qb-creates/pov-led-clock/images/case-inside.JPEG

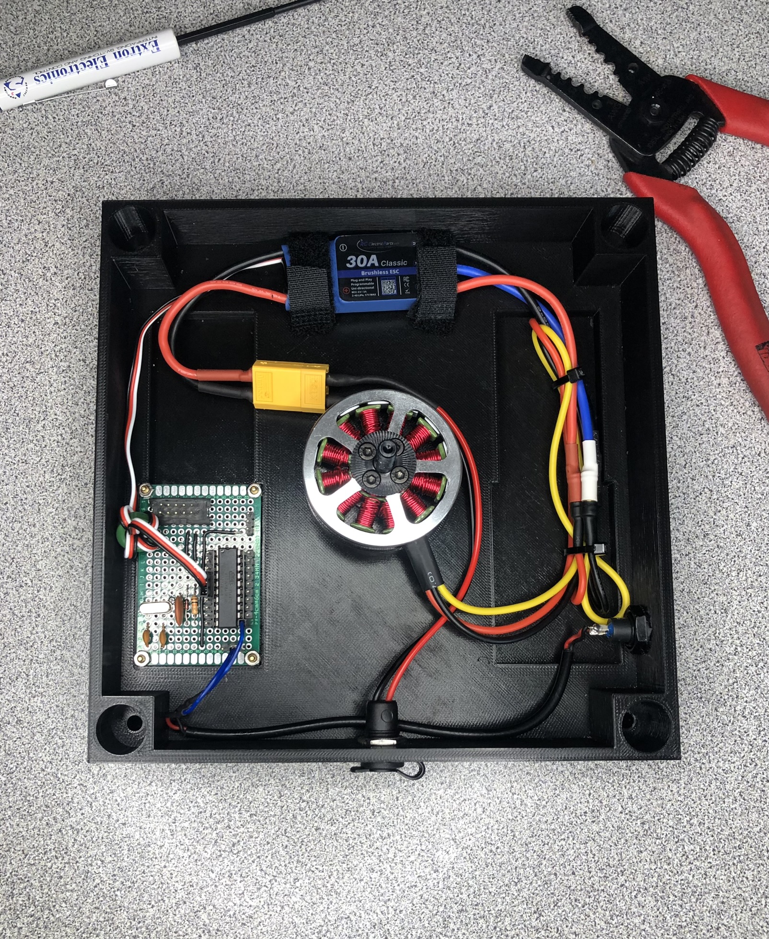
images/case-inside.JPEG
