qb-creates/pov-led-clock/images/pov-led-clock.JPEG

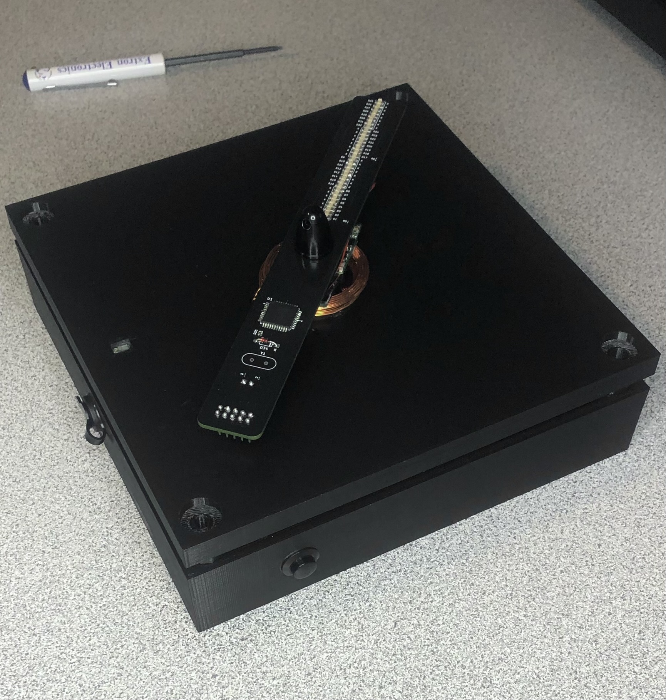
images/pov-led-clock.JPEG
