qb-creates/pov-led-clock/case/pov-clock-case.stl

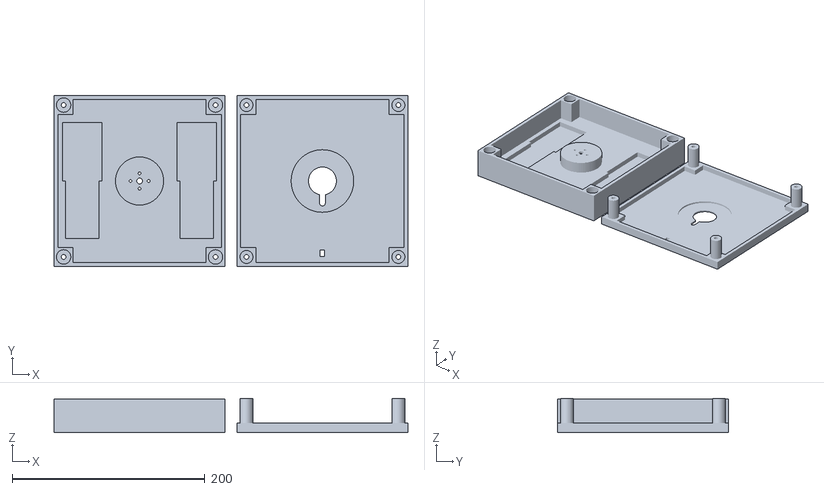
[picture p12: CAD file, 2023-10-21]
case/pov-clock-case.stl
367.8 x 177.8 x 35.4
