qb-creates/pov-led-clock/(list of files, cad)

Other CAD files:
case/pov-clock-case.f3d
