qb-creates/pov-led-clock/eda/pov-clock-kicad/LedClock.kicad_pcb

## KiCad design eda/pov-clock-kicad/LedClock.kicad_pcb (2023-05-27)

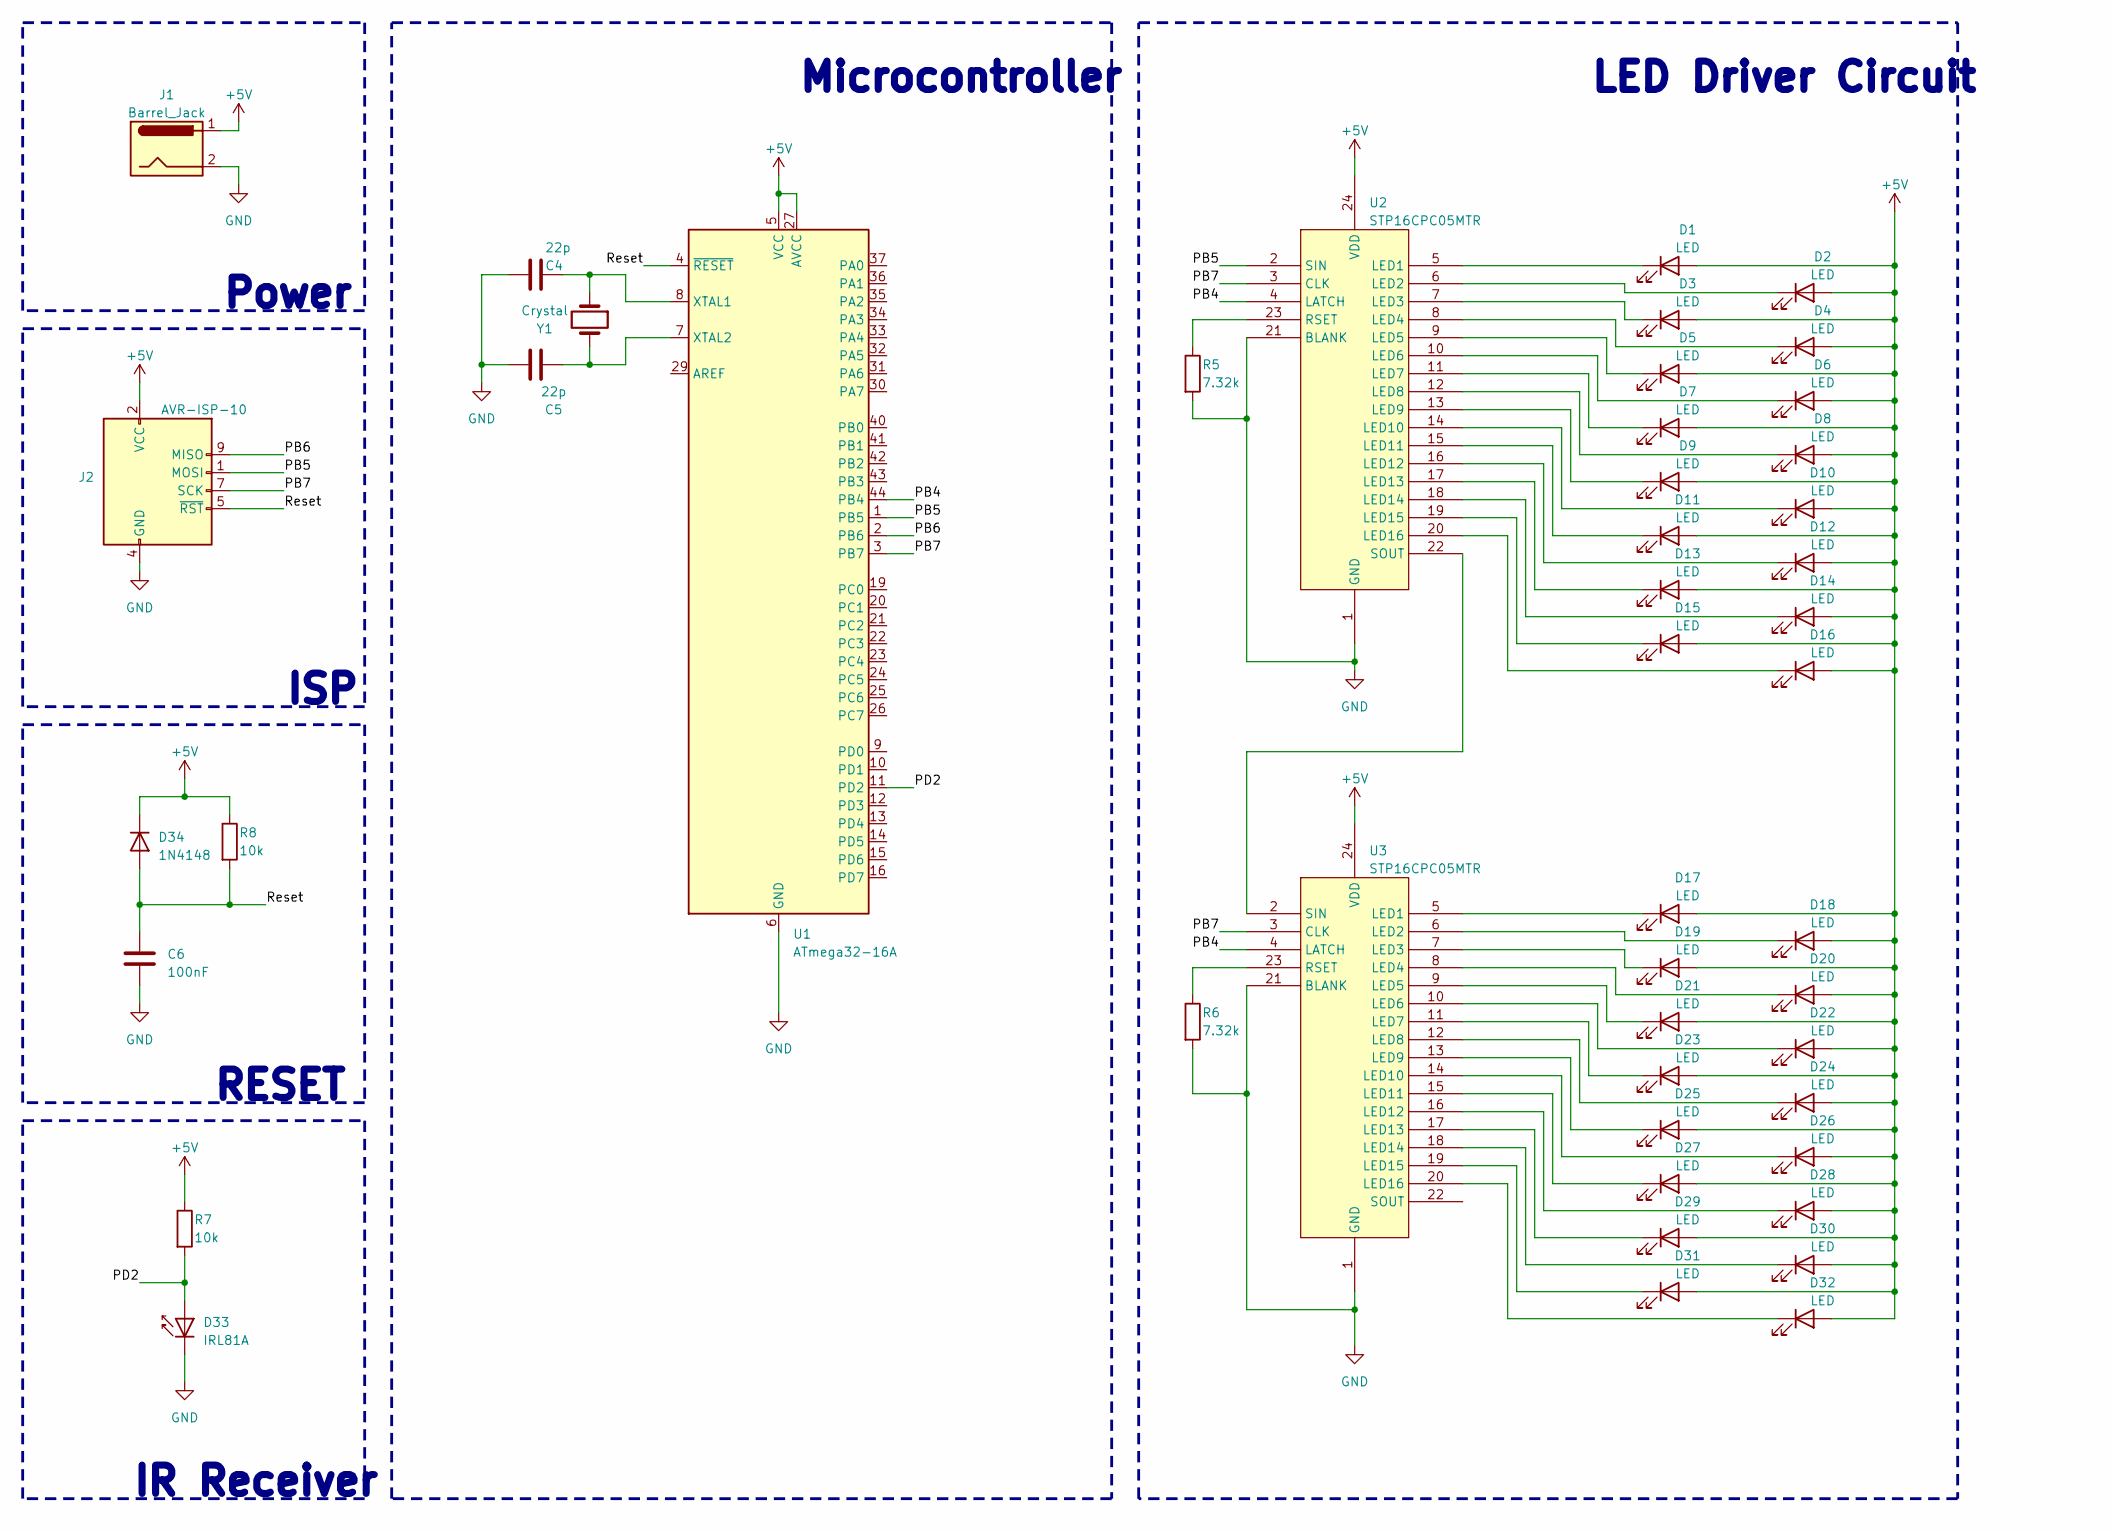
[picture p13: schematic LedClock.kicad_sch]

Parts:
C4, C5: 22p; C_0603_1608Metric
C6: 100nF; C_0603_1608Metric
D1, D2, D3, D4, D5, D6, D7, D8, D9, D10, D11, D12, D13, D14, D15, D16, D17, D18, D19, D20, D21, D22, D23, D24, D25, D26, D27, D28, D29, D30, D31, D32: LED; LED_1206_3216Metric
D33: IRL81A; LED_SideEmitter_Rectangular_W4.5mm_H1.6mm
D34: 1N4148; D_DO-35_SOD27_P7.62mm_Horizontal
J1: Barrel_Jack; JST_PH_S2B-PH-SM4-TB_1x02-1MP_P2.00mm_Horizontal
J2: AVR-ISP-10; ISP-10
R5, R6: 7.32k; R_0603_1608Metric
R7, R8: 10k; R_0603_1608Metric
U1: ATmega32-16A; TQFP-44_10x10mm_P0.8mm
U2, U3: STP16CPC05MTR; SOIC-24W_7.5x15.4mm_P1.27mm
Y1: Crystal; Crystal_HC49-4H_Vertical

Connections:
+5V: D1.2 (A), D2.2 (A), D3.2 (A), D4.2 (A), D5.2 (A), D6.2 (A), D7.2 (A), D8.2 (A), D9.2 (A), D10.2 (A), D11.2 (A), D12.2 (A), D13.2 (A), D14.2 (A), D15.2 (A), D16.2 (A), D17.2 (A), D18.2 (A), D19.2 (A), D20.2 (A), D21.2 (A), D22.2 (A), D23.2 (A), D24.2 (A), D25.2 (A), D26.2 (A), D27.2 (A), D28.2 (A), D29.2 (A), D30.2 (A), D31.2 (A), D32.2 (A), D34.1 (K), J1.1, J2.2 (VCC), R7.1, R8.1, U1.5 (VCC), U1.17 (VCC), U1.27 (AVCC), U1.38 (VCC), U2.24 (VDD), U3.24 (VDD)
/PB4: U1.44 (PB4), U2.4 (LATCH), U3.4 (LATCH)
/PB5: J2.1 (MOSI), U1.1 (PB5), U2.2 (SIN)
/PB6: J2.9 (MISO), U1.2 (PB6)
/PB7: J2.7 (SCK), U1.3 (PB7), U2.3 (CLK), U3.3 (CLK)
/PD2: D33.2 (A), R7.2, U1.11 (PD2)
/Reset: C6.1, D34.2 (A), J2.5 (~RST), R8.2, U1.4 (~RESET)
GND: C4.2, C5.2, C6.2, D33.1 (K), J1.2, J2.4 (GND), J2.6 (GND), J2.8 (GND), J2.10 (GND), R5.2, R6.2, U1.6 (GND), U1.18 (GND), U1.28 (GND), U1.39 (GND), U2.1 (GND), U2.21 (BLANK), U3.1 (GND), U3.21 (BLANK)
unnamed: D1.1 (K), U2.5 (LED1)
unnamed: D2.1 (K), U2.6 (LED2)
unnamed: D3.1 (K), U2.7 (LED3)
unnamed: D4.1 (K), U2.8 (LED4)
unnamed: D5.1 (K), U2.9 (LED5)
unnamed: D6.1 (K), U2.10 (LED6)
unnamed: D7.1 (K), U2.11 (LED7)
unnamed: D8.1 (K), U2.12 (LED8)
unnamed: D9.1 (K), U2.13 (LED9)
unnamed: D10.1 (K), U2.14 (LED10)
unnamed: D11.1 (K), U2.15 (LED11)
unnamed: D12.1 (K), U2.16 (LED12)
unnamed: D13.1 (K), U2.17 (LED13)
unnamed: D14.1 (K), U2.18 (LED14)
unnamed: D15.1 (K), U2.19 (LED15)
unnamed: D16.1 (K), U2.20 (LED16)
unnamed: D17.1 (K), U3.5 (LED1)
unnamed: D18.1 (K), U3.6 (LED2)
unnamed: D19.1 (K), U3.7 (LED3)
unnamed: D20.1 (K), U3.8 (LED4)
unnamed: D21.1 (K), U3.9 (LED5)
unnamed: D22.1 (K), U3.10 (LED6)
unnamed: D23.1 (K), U3.11 (LED7)
unnamed: D24.1 (K), U3.12 (LED8)
unnamed: D25.1 (K), U3.13 (LED9)
unnamed: D26.1 (K), U3.14 (LED10)
unnamed: D27.1 (K), U3.15 (LED11)
unnamed: D28.1 (K), U3.16 (LED12)
unnamed: D29.1 (K), U3.17 (LED13)
unnamed: D30.1 (K), U3.18 (LED14)
unnamed: D31.1 (K), U3.19 (LED15)
unnamed: D32.1 (K), U3.20 (LED16)
unnamed: C4.1, U1.8 (XTAL1), Y1.1
unnamed: C5.1, U1.7 (XTAL2), Y1.2
unnamed: R5.1, U2.23 (RSET)
unnamed: U2.22 (SOUT), U3.2 (SIN)
unnamed: R6.1, U3.23 (RSET)

Notes on the sheet:
Power
ISP
RESET
Microcontroller
LED Driver Circuit
IR Receiver

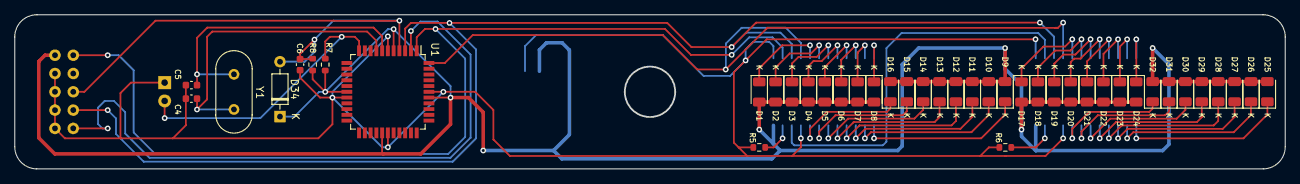
[picture p14: board LedClock.kicad_pcb from above]

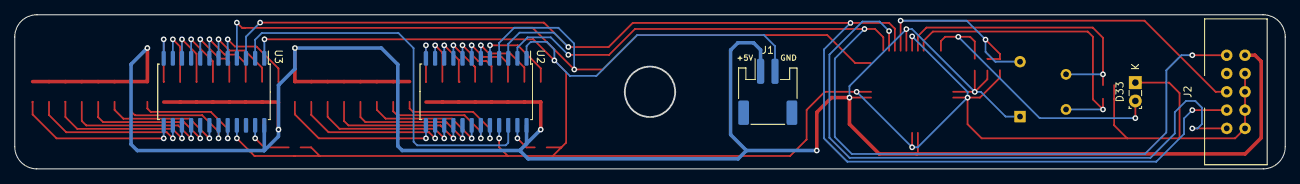
[picture p15: board LedClock.kicad_pcb from below]

Board: 2 copper layers, 176.4 x 21.4 mm, 47 parts (5 on the bottom side), 45 nets.
