qb-creates/pov-led-clock/(commit log)

2021-11-09 Add solution
    [Parts List.xlsx]
2023-04-16 adding Attiny pwm project
2023-04-16 Removed Parts List. Renamed images. Updated Readme.
    [Parts List.xlsx]
2023-04-16 Updated gitignore to include kicad ignore files
2023-04-16 Updated gitignore to ignore kicad backup folder
2023-04-16 adding kicad project
    [LedClock.kicad_pcb, LedClock.kicad_sch]
2023-04-16 Added led-circuit-schematic
2023-05-27 Connected AVCC to the 5 volts rail.
    [LedClock.kicad_pcb, LedClock.kicad_sch]
2023-06-12 Fixed bug in the configureInput function and updated comments.
    [main.c]
2023-10-07 Updated comments for esc driver code
2023-10-16 - Updated image of the led circuit schematic - Created an esc driver kicad file - Added an immage of the esc driver circuit
    [ESCDriver.kicad_pcb, ESCDriver.kicad_sch]
2023-10-16 - updated the esc driver kicad file directory
    [ESCDriver.kicad_pcb, ESCDriver.kicad_sch]
2023-10-16 - Added the esc driver circuit image to the readme file
2023-10-16 Update esc schematic file extension
2023-10-16 - Added ir transmitter to the esc driver circuit. - Updated readme file
2023-10-16 - updated teh esc drive circuit schematic
2023-10-18 - Updated folder struction of the repo - Created an eda folder that holds KiCad files - Created a software folder that holds the microcontroller programs. - Moved everything into the appropriate fold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
    [ESCDriver.kicad_pcb, ESCDriver.kicad_sch, LedClock.kicad_pcb, LedClock.kicad_sch]
2023-10-18 - Added case files - Added image of the clock powered - Updated readme file
    [Case v40.stl, pov-clock-case.f3d]
2023-10-21 Update README.md
    Update the esc circuit description in the readme file
2023-10-21 Update README.md
    Updated the PWM Overview section of the readme file
2023-10-21 - Aded new image of the case
2023-10-21 Update README.md
    - Updated the timer section of the readme file
2023-10-21 Update README.md
    - updated the LED drivers section on the readme file
2023-10-21 Update README.md
    - updated led driver section of the readme file
2023-10-21 Update README.md
    - Updated the led driver table in the readme file
2023-10-21 Update README.md
    - Updated led driver table in the readme file
2023-10-21 - renamed case stl file
    [Case v40.stl, pov-clock-case.stl]
2023-10-21 Update README.md
    - added case stl to readme file
2023-10-21 Update README.md
    - added stl ascii for the case to the readme file
2023-10-21 Update README.md
    - replaced the led clock image in the readme file
2023-10-21 - added a divered between the schematics in the readme file
2023-10-21 Update README.md
    - Added a power consumption table to the readme file
2023-10-21 Update README.md
    - renamed the powersupply link in the readme file
2023-10-21 - updated PWM overview in the readme file
